xiaobaia222/fork_violentFan/fan_code/fan.md

# 暴力风扇 v2.0 重写项目

基于 STC8H 系列 MCU 的 2S 无刷暴力风扇控制器，参考 `ref_files/Violent-fan-v2.0` 开源代码进行模块化重写。

## 硬件概要

- MCU: STC8H 系列，主频 35MHz
- 电机: 2S 无刷直流电机，3 路 PWM + 互补输出 (P1.0~P1.5)
- LED: RGB 三色共阳 (R=P1.7, G=P5.4, B=P1.6)
- 按键: 单键 P3.7，支持短按/长按/双击
- 电池: 2S 锂电，ADC 通道 10 检测电压，分压比 470/(330+470)
- 充电检测: VBUS_SENSE = P3.0
- 电源开关: POWER_SWITCH = P3.1

## 模块划分

| 模块 | 文件 | 职责 |
|---|---|---|
| 主程序 | main.c/h | 时钟初始化、系统状态机、全局变量、中断入口 |
| 通用工具 | common.c/h | delay_ms、delay_us |
| LED | led.c/h | RGB LED 初始化与开关控制 |
| 按键 | key.c/h | 按键扫描(状态机)、按键事件处理 |
| 电机 | motor.c/h | PWM 初始化、六步换相、开环启动、停机 |
| ADC/电池 | adc_bat.c/h | ADC 通道10 电池电压采样、16 点去极值平均、低压保护 |
| 蜂鸣器 | (待建) | 自检蜂鸣、低压蜂鸣 |

## 开发进度

### 已完成

- [x] 项目结构搭建，模块化拆分
- [x] 时钟初始化 (35MHz)
- [x] 延时函数 (delay_ms, delay_us, delay_500ns)
- [x] LED 驱动 (RGB 推挽输出, 单色/全部开关)
- [x] 按键模块 (标准6状态消抖状态机, 短按/长按/双击)
- [x] P3.7 内部上拉使能 (P3PU)
- [x] Timer2 10ms 中断时基 + tick_10ms 节拍
- [x] LED 指示档位 (仅状态变化时更新)
- [x] 电机驱动 (motor.c)
  - [x] GPIO 初始化 (P1.0~P1.5 推挽, P3.2~P3.6 高阻, POWER_SWITCH)
  - [x] PWMA 3 通道初始化 (34kHz, 死区24T, 8位分辨率)
  - [x] ADC 初始化 (为比较器提供正输入)
  - [x] 比较器初始化 (P3.6 反相输入, 60T 滤波)
  - [x] Timer0 换相/消磁定时 + ISR
  - [x] Timer1 换相间隔测量 + ISR
  - [x] 比较器 ISR (反电动势过零检测)
  - [x] 六步换相 motor_step
  - [x] 开环启动 motor_start (渐进加速)
  - [x] 闭环切入 motor_enter_run
  - [x] 停机 motor_stop
  - [x] PWM 设置 motor_set_pwm
- [x] AM32 风格电机驱动改进
  - [x] CMP_Isr 时间窗口过滤 (< phase_time/2 丢弃)
  - [x] CMP_Isr 连续采样验证 (filter_level 次确认)
  - [x] 自适应 filter_level (10ms tick 中按转速动态调整: 8/4/2)
  - [x] IIR 滤波替代 8 点平均 (75/25 权重)
  - [x] 可配置换相提前角 (ADVANCE_LEVEL 0~3, 默认 15°)
  - [x] 消磁延时独立为 phase_time/4
  - [x] 过零计数器 zero_crosses
  - [x] 失同步检测 (CMP_Isr 中 50% 突变 → desync_flag)
  - [x] timer1_read_cnt 非破坏性读取
- [x] 主循环集成
  - [x] 10ms 节拍驱动
  - [x] PWM 一阶低通平滑
  - [x] 占空比变化率钳位 (PWM_RAMP_SLOW=3, PWM_RAMP_FAST=10)
  - [x] 失同步恢复 (油门减半 + 重置 zero_crosses)
  - [x] 堵转检测与超时停机
  - [x] 运行/闲置超时自动关机

- [x] ADC 电池电压检测 (adc_bat.c/h)
  - [x] 16 点环形缓冲去极值平均
  - [x] 低压保护阈值 6.4V (BAT_ADC_LOW=770)
  - [x] 低压自动恢复 (电压回升自动清除 STA_BATLOW)
  - [x] 低压停机蓝灯闪烁 4 次提示后休眠
- [x] 系统状态机 (main.c)
  - [x] STA_SLEEP: IDL 低功耗模式, Timer2 中断唤醒
  - [x] STA_WAKING: 长按唤醒, 判断 VBUS 决定运行/充电
  - [x] STA_CHARGING: 充电线接入检测 (轮询 VBUS_SENSE P3.0)
  - [x] 运行中插充电线立即停机进入充电休眠
  - [x] 上电默认休眠, 长按唤醒
  - [x] P3.0 高阻输入配置

### 待开发

- [ ] 蜂鸣器模块
  - [ ] 自检蜂鸣 (self_check_beebee)
  - [ ] 低压蜂鸣 (bat_low_beebee) — 当前为桩函数

## 参考代码对照

参考代码为单文件 `violent v2.0.c` (~575 行)，主要参数：

- 油门档位: 4 档 {0, 30, 80, 150}
- 蜂鸣音量: 40
- 启动油门: 40
- 堵转超时: 500ms
- 运行超时: 5min
- 闲置超时: 30s
- 低压阈值: 6.4V
