xiaobaia222/fork_violentFan/fork_Fan/设计指导.md

# 验证
电路主要参考violent_fan电路驱动，和其代码驱动先验证原电路板是否正常工作

# 改进电路 

  - [ ] 添加换启动电路参考axdr 开源驱动板，后续验证电源波形

 - [ ] 添加防反接电路 参考axdr， 利用mos管和两个电阻还有稳压管组成

 - [ ] 电池电容增加一些，加到220uf 10个22uf陶瓷电容

 - [ ] 单片机电源改为dcdc
