xiaobaia222/fork_violentFan/ref_files/Violent-fan-v2.0/HARDWARE/violent fan-v2.0-Bom.xlsx

Comment | Description | Designator | Footprint | Quantity | 参考购买链接
电容
10nF | 贴片陶瓷电容 | C9, C10, C11, C17 | C-0603-M | 4 | https://youxin-electronic.taobao.com/category-1145410923.htm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
100nF | 贴片陶瓷电容 | C3, C4, C16 | C-0603-M | 3
1uF | 贴片陶瓷电容 | C1, C6 | C-0603-M | 2
10uF | 贴片陶瓷电容 | C12, C13, C14 | C-0603-M | 3
10uF/16v | 贴片陶瓷电容 | C7, C15 | C-1206-M | 2 | https://item.taobao.com/item.htm?spm=a1z10.5-c-s.w4002-21223910190.22.aafd4da9AAzP4G&id=537890885062
22uF/16v | 贴片陶瓷电容 | C8 | C-1206-M | 1 | https://item.taobao.com/item.htm?spm=a1z10.3-c-s.w4002-21223910208.27.65956a4bOVW7yL&id=653433995995
100uF/16v | 贴片钽电容，耐压16V | C2 | C-6032-N | 1 | https://item.taobao.com/item.htm?spm=a1z09.2.0.0.360a2e8daiR1EQ&id=537026568564&_u=8b2i1bf7766 | 1.97
220uF/6.3v | 贴片钽电容，耐压6.3V | C5 | C-6032-N | 1 | https://item.taobao.com/item.htm?spm=a1z09.2.0.0.360a2e8daiR1EQ&id=536877747914&_u=8b2i1bfedb9 | 1.23
电阻
5R1 | 贴片电阻 | R15, R16, R17, R20, R21, R22 | R-0603-M | 6 | https://youxin-electronic.taobao.com/category-1171156354.htm?search=y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
22R | 贴片电阻 | R6 | R-0603-M | 1
1k | 贴片电阻 | R1, R32, R33, R35 | R-0603-M | 4
2k | 贴片电阻 | R9, R28, R29, R30 | R-0603-M | 3
4.7k | 贴片电阻 | R5 | R-0603-M | 1
5.1k | 贴片电阻 | R2, R3 | R-0603-M | 2
10k | 贴片电阻 | R4, R7, R8, R10, R11, R12, R13, R14, R18, R19, R23, R24, R25, R26, R27 | R-0603-M | 15
470k,%1 | 贴片电阻，精度1% | R34 | R-0603-M | 1 | https://item.taobao.com/item.htm?spm=a1z0d.6639537/tb.1997196601.417.2b537484oaNrWL&id=525878598378
330k,%1 | 贴片电阻，精度%1 | R31 | R-0603-M | 1 | https://item.taobao.com/item.htm?spm=a1z0d.6639537/tb.1997196601.425.2b537484oaNrWL&id=525884117853
二极管
LED-Red | 贴片红色发光二极管 | D1 | LED-0603 | 1 | https://item.taobao.com/item.htm?spm=a1z10.5-c-s.w4002-21223910190.14.121d15c27rmve0&id=522554271548
LED-RGB | 贴片三色LED | LED1 | LED 3528-4Pin | 1 | https://item.taobao.com/item.htm?spm=a1z10.5-c-s.w4002-21223910190.19.7c4115c2oQqiQW&id=544589431307
DSK34 | 贴片肖特基二极管，3A/40V | D2 | SOD-123 | 1 | https://item.taobao.com/item.htm?spm=a1z09.2.0.0.360a2e8daiR1EQ&id=545427044723&_u=8b2i1bf12fe
1N5819 | 贴片肖特基二极管 | D3, D4, D5, D6, D7, D8, D9, D10, D11 | SOD-323 | 9 | https://item.taobao.com/item.htm?spm=a1z09.2.0.0.360a2e8daiR1EQ&id=522574162326&_u=8b2i1bf39b5
三极管
S8050 | NPN型三极管 | Q2 | SOT-23 | 1 | https://item.taobao.com/item.htm?spm=a1z10.3-c-s.w4002-21223910208.11.7d136a4blLuj8S&id=522577964105
场效应管
AO3401 | P沟道场效应管 | Q1 | SOT-23 | 1 | https://item.taobao.com/item.htm?spm=a1z10.3-c-s.w4002-21223910208.9.edcb6a4bhz39m5&id=522554663865
AO3400 | N沟道场效应管 | Q3 | SOT-23 | 1 | https://item.taobao.com/item.htm?spm=a1z10.3-c-s.w4002-21223910208.9.19a96a4bDO75NZ&id=522574089119
NCE3035G | N沟道场效应管 | Q4, Q5, Q6, Q7, Q8, Q9 | DFN5x6_8L_EP1_P | 6 | https://item.taobao.com/item.htm?spm=a1z09.2.0.0.360a2e8daiR1EQ&id=674377712129&_u=9b2i1bf9a08 | 5.4
电感
SWPA5040S2R2MT | 贴片功率电感，2.2uH | L1 | CD54 | 1 | https://item.taobao.com/item.htm?spm=a1z09.2.0.0.360a2e8daiR1EQ&id=588708208400&_u=8b2i1bfc21c
集成芯片
CS5086E | 5VUSB输入，最大1.5A充电电流，带NTC及电量均衡功能，双节锂电池升压充电管理电路 | U1 | ESOP10L | 1 | https://item.taobao.com/item.htm?spm=a1z09.2.0.0.360a2e8daiR1EQ&id=673629016970&_u=9b2i1bf9d44 | 2.6
HT7150-1 | 低压差线性稳压器，5.0v，低静态电流 | U2 | SOT-89 | 1 | https://item.taobao.com/item.htm?spm=a1z09.2.0.0.35d32e8dRJrr89&id=652800148041&_u=pb2i1bf031e | 0.31
FD6288Q | 三相250V栅极驱动器 | U3 | QFN24 4x4 | 1 | https://item.taobao.com/item.htm?spm=a1z09.2.0.0.360a2e8daiR1EQ&id=613309462834&_u=9b2i1bf50a8 | 2.05
STC8H1K08 | 增强型51单片机 | U4 | TSSOP20_L | 1 | https://item.taobao.com/item.htm?spm=a1z10.3-c-s.w4002-21223910208.9.7b0c6a4bZpuTNI&id=638457107145 | 1.9
其他
10A/125V | 贴片保险丝 | F1 | FU 1808 | 1 | https://item.taobao.com/item.htm?spm=a1z09.2.0.0.360a2e8daiR1EQ&id=560195140249&_u=8b2i1bf47e2
Button | 贴片轻触开关，6*6*10 | SW1 | TSW SMD-6*6*10 | 1 | https://item.taobao.com/item.htm?spm=a1z10.3-c-s.w4002-21223910208.36.84b36a4bzG9Zgw&id=556973844714
USB-C | USB-C型母接口，6Pin | USB1 | USB-C-SMD_10P | 1 | https://item.taobao.com/item.htm?spm=a1z09.2.0.0.360a2e8daiR1EQ&id=573089663803&_u=8b2i1bf3aa2
HDR-1X4 | 2.54间距插针，4P | JP1 | HDR2.54-LI-4P-SMD | 1
BATTERY_DUAL | 贴片18650电池座，镀金，双排 | B1 | 18650电池座2P-贴片式 | 1 | https://item.taobao.com/item.htm?spm=a1z09.2.0.0.360a2e8daiR1EQ&id=589677534830&_u=8b2i1bfd1b0 | 2.69
无刷电机 | 1804无刷电机，2700kv，正螺纹 | M1 |  | 1 | https://item.taobao.com/item.htm?spm=a1z09.2.0.0.71df2e8dctWBSB&id=654440708357&_u=ab2i1bf266e | 14
螺丝 | 304十字盘头螺钉，M2*4，用于固定PCB |  |  | 2 | https://detail.tmall.com/item.htm?id=39158180791&spm=a1z09.2.0.0.6e672e8d4W5PQt&_u=mb2i1bfdf1f
螺丝 | 305十字盘头螺钉，M2*5，用于固定电机 |  |  | 4
螺母 | 304六角螺母，M5，用于固定桨叶 |  |  | 1 | https://detail.tmall.com/item.htm?id=14498839719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
桨叶 | 3.5寸8叶FPV螺旋桨 |  |  | 1 | https://item.taobao.com/item.htm?spm=a1z09.2.0.0.64462e8dkVTr0w&id=642183971152&_u=pb2i1bfa4d5 | 4.25
电池 | 动力18650电池，10A放电 |  |  | 2 | https://item.taobao.com/item.htm?spm=a1z09.2.0.0.35d32e8dRJrr89&id=571620099259&_u=pb2i1bf4f0f | 14.5
