xiaobaia222/fork_violentFan/ref_files/Violent-fan-v2.0/3DMODEL/风扇整体.SLDASM

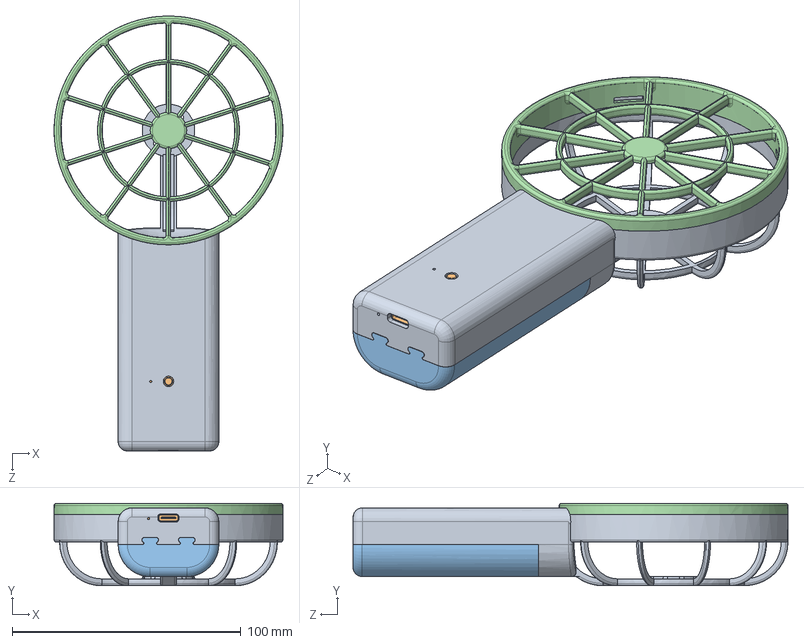
[picture p14: CAD file, 2026-01-29]
ref_files/Violent-fan-v2.0/3DMODEL/风扇整体.SLDASM
100.0 x 36.0 x 190.1 mm
风扇外壳
violent fan-v2.0
风扇后盖
风扇前盖
