xiaobaia222/fork_violentFan/ref_files/Violent-fan-v2.0/3DMODEL/风扇外壳.SLDPRT

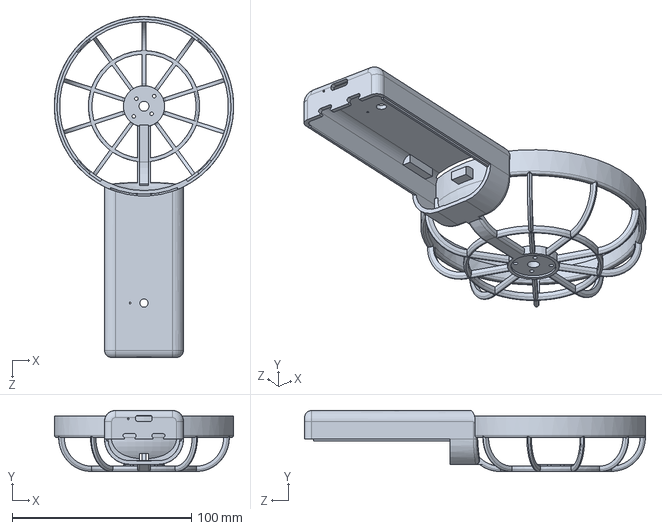
[picture p15: CAD file, 2026-01-29]
ref_files/Violent-fan-v2.0/3DMODEL/风扇外壳.SLDPRT
100.0 x 34.0 x 190.0 mm
