xiaobaia222/fork_violentFan/ref_files/Violent-fan-v2.0/3DMODEL/风扇前盖.SLDPRT

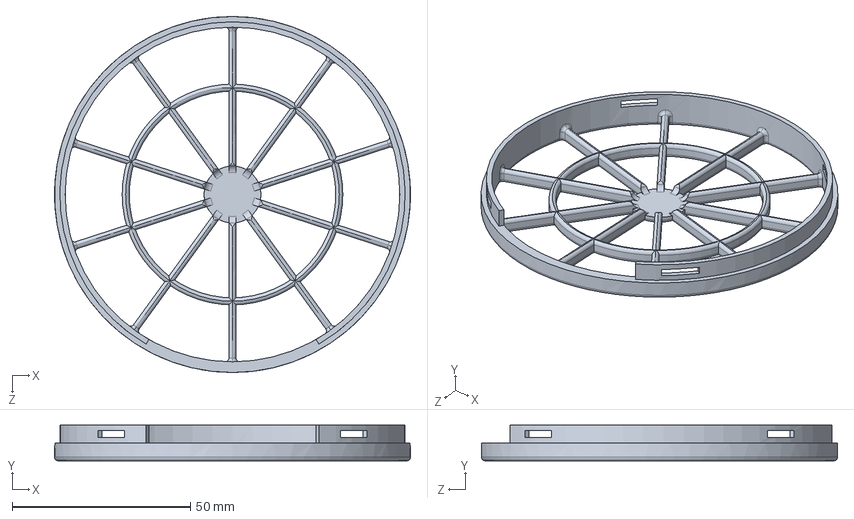
[picture p16: CAD file, 2026-01-29]
ref_files/Violent-fan-v2.0/3DMODEL/风扇前盖.SLDPRT
100.0 x 10.0 x 100.0 mm
