xiaobaia222/fork_violentFan/ref_files/Violent-fan-v2.0/3DMODEL/风扇后盖.SLDPRT

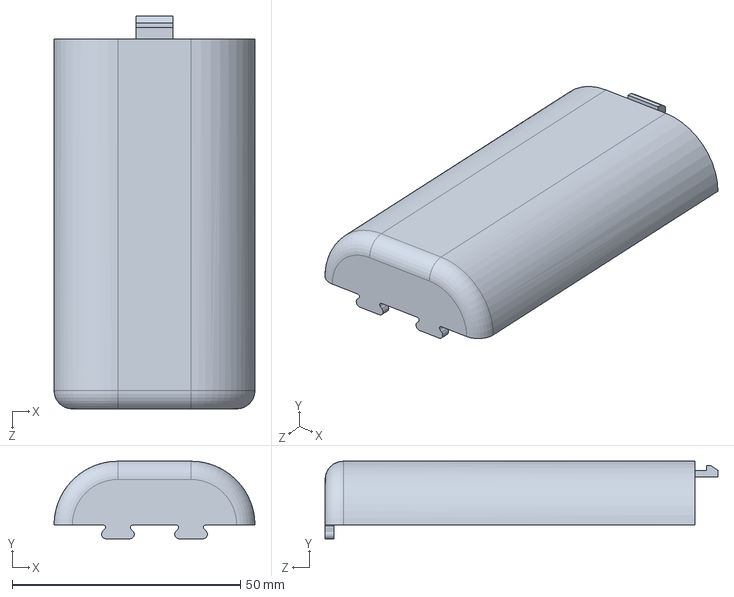
[picture p17: CAD file, 2026-01-29]
ref_files/Violent-fan-v2.0/3DMODEL/风扇后盖.SLDPRT
44.0 x 17.0 x 86.0 mm
