xiaobaia222/fork_violentFan/ref_files/Violent-fan-v2.0/3DMODEL/violent fan-v2.0.SLDPRT

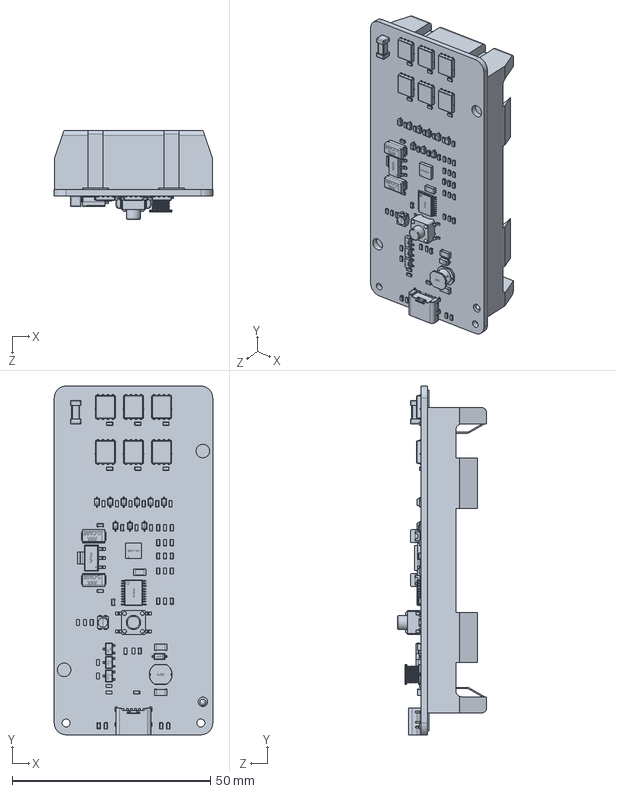
[picture p18: CAD file, 2026-01-29]
ref_files/Violent-fan-v2.0/3DMODEL/violent fan-v2.0.SLDPRT
40.0 x 88.0 x 22.5 mm
