xiaobaia222/fork_violentFan/(list of files, cad)

Other CAD files:
ref_files/Violent-fan-v2.0/3DMODEL/风扇前盖.STL
ref_files/Violent-fan-v2.0/3DMODEL/风扇后盖.STL
ref_files/Violent-fan-v2.0/3DMODEL/风扇外壳.STL
