xiaobaia222/fork_violentFan/fan_code/build_log.txt

Build target 'fan_fork'
compiling main.c...
linking...
*** WARNING L16: UNCALLED SEGMENT, IGNORED FOR OVERLAY PROCESS
    SEGMENT: ?PR?RED_ONLY?LED

*** WARNING L16: UNCALLED SEGMENT, IGNORED FOR OVERLAY PROCESS
    SEGMENT: ?PR?GREEN_ONLY?LED

*** WARNING L16: UNCALLED SEGMENT, IGNORED FOR OVERLAY PROCESS
    SEGMENT: ?PR?BLUE_ONLY?LED

*** WARNING L16: UNCALLED SEGMENT, IGNORED FOR OVERLAY PROCESS
    SEGMENT: ?PR?LED_ALL_ON?LED

*** WARNING L16: UNCALLED SEGMENT, IGNORED FOR OVERLAY PROCESS
    SEGMENT: ?PR?BAT_GET_ADC?ADC_BAT

Program Size: data=72.6 xdata=0 code=2862
creating hex file from ".\Objects\fan_fork"...
".\Objects\fan_fork" - 0 Error(s), 5 Warning(s).
Build Time Elapsed:  00:00:01
