xiaobaia222/fork_violentFan/(list of files, drawings)

Other design files:
ref_files/Violent-fan-v2.0/HARDWARE/violent fan-v2.0.PcbDoc
