xiaobaia222/fork_violentFan/fork_Fan/fork_Fan.kicad_pcb

## KiCad design fork_Fan/fork_Fan.kicad_pcb (2026-02-11)

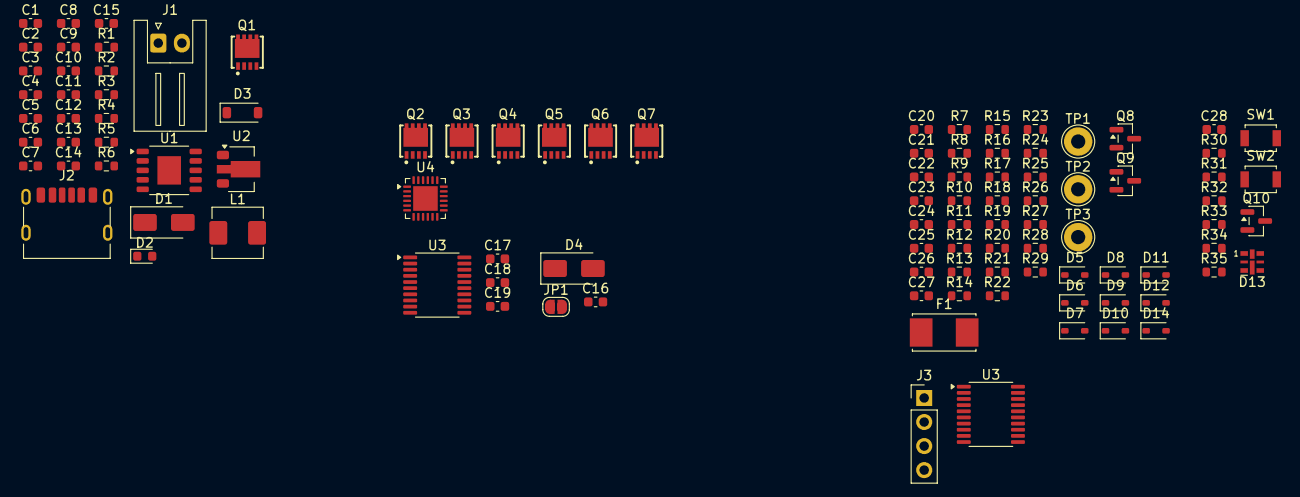
[picture p19: board fork_Fan.kicad_pcb from above]

Board: 2 copper layers, 103 parts (0 on the bottom side), 48 nets, no tracks yet.

Parts:
C1, C3, C5, C6, C7, C8, C10, C11, C12, C14, C26, C27: 10uF; C_0603_1608Metric
C2, C4, C9, C13, C15, C16, C19, C28: 100nF; C_0603_1608Metric
C17, C18: 22uF; C_0603_1608Metric
C20, C21, C22: 10nF; C_0603_1608Metric
C23, C24, C25: 1uF; C_0603_1608Metric
D1, D4: SS54; D_SMA
D2: LED; LED_0603_1608Metric
D3: BZT52B5V6; D_SOD-123
D5, D6, D7, D8, D9, D10, D11, D12, D14: 1N5819WS; D_SOD-323
D13: APA102-2020; LED-APA102-2020
F1: Fuse; Fuseholder_Littelfuse_Nano2_157x
J1: Conn_01x02; JST_XH_S2B-XH-A_1x02_P2.50mm_Horizontal
J2: USB_C_Receptacle_PowerOnly_6P; USB_C_Receptacle_HRO_TYPE-C-31-M-17
J3: Conn_01x04; PinHeader_1x04_P2.54mm_Vertical
JP1: SolderJumper_2_Open; SolderJumper-2_P1.3mm_Open_RoundedPad1.0x1.5mm
L1: 2.2uH; L_APV_APH0530
Q1, Q2, Q3, Q4, Q5, Q6, Q7: Q_NMOS; PDFN-8_L3.3-W3.3-P0.65-BL-DSG
Q8: AO3401A; SOT-23
Q9, Q10: SS8050; SOT-23
R1, R2, R4, R5: 5.1K; R_0603_1608Metric
R3: 7.5K; R_0603_1608Metric
R6, R33: 100K; R_0603_1608Metric
R7, R8, R9, R10, R11, R12: 5.1R; R_0603_1608Metric
R13, R14, R15, R16, R17, R18, R19, R20, R21, R22, R23, R24, R28, R31: 10K; R_0603_1608Metric
R25, R26, R27, R29, R30, R34, R35: 2K; R_0603_1608Metric
R32: 200K; R_0603_1608Metric
SW1, SW2: SW_Push; SW_SPST_B3U-1000P
TP1, TP2, TP3: TestPoint; TestPoint_THTPad_D3.0mm_Drill1.5mm
U1: CS5086E; SSOP-10-1EP_3.9x4.9mm_P1mm_EP2.5x3.0mm
U2: HT7150-1; SOT-89-3
U3: STC8G1K08-38I-TSSOP20; TSSOP-20_4.4x6.5mm_P0.65mm
U3#2: STC8H1K08-38I-TSSOP20; TSSOP-20_4.4x6.5mm_P0.65mm
U4: FD6288Q; QFN-24-1EP_4x4mm_P0.5mm_EP2.6x2.6mm

Connections:
+5V: C14.1, C15.1, C17.1, C18.1, C19.1, D13.1 (VDD), J3.1, U2.3 (VOUT), U3.8 (VCC), U3#2.8 (VCC), U3#2.9 (ADC_VRef+)
/IO_opera/bat_sample: C28.1, R34.1
/motor_driver/A: C23.2, Q2.D, Q3.S, R13.2, R19.1, TP1.1, U4.18 (VS1)
/motor_driver/ADC11: C20.2, R19.2, R22.1, R25.1
/motor_driver/ADC12: C21.2, R20.2, R23.1, R26.1
/motor_driver/ADC13: C22.2, R21.2, R24.1, R27.1
/motor_driver/B: C24.2, Q4.D, Q5.S, R14.2, R20.1, TP2.1, U4.15 (VS2)
/motor_driver/C: C25.2, Q6.D, Q7.S, R18.2, R21.1, TP3.1, U4.12 (VS3)
/motor_driver/COMP-: R22.2, R23.2, R24.2
/motor_driver/M_A_H1: D5.1 (K), R7.1, U4.19 (HO1)
/motor_driver/M_A_L1: D6.1 (K), R8.1, U4.11 (LO1)
/motor_driver/M_B_H2: D7.1 (K), R9.1, U4.16 (HO2)
/motor_driver/M_B_L2: D8.1 (K), R10.1, U4.10 (LO2)
/motor_driver/M_C_H3: D9.1 (K), R11.1, U4.13 (HO3)
/motor_driver/M_C_L3: D10.1 (K), R12.1, U4.9 (LO3)
/motor_driver/VB_A: C23.1, D14.1 (K), U4.20 (VB1)
/motor_driver/VB_B: C24.1, D11.1 (K), U4.17 (VB2)
/motor_driver/VB_C: C25.1, D12.1 (K), U4.14 (VB3)
/stc_mcu/RX: J3.4, U3#2.12 (TxD/ADC9/P3.1)
/stc_mcu/TX: J3.3, U3#2.11 (INT4/RxD/ADC8/P3.0)
GND: C1.2, C2.2, C3.2, C4.2, C5.2, C6.2, C7.2, C8.2, C9.2, C10.2, C11.2, C12.2, C13.2, C14.2, C15.2, C16.2, C17.2, C18.2, C19.2, C20.1, C21.1, C22.1, C26.2, C27.2, C28.2, D3.2 (A), D13.6 (GND), J2.A12 (GND), J2.B12 (GND), J2.S1 (SHIELD), J3.2, Q1.S, Q3.D, Q5.D, Q7.D, Q9.2 (E), Q10.2 (E), R1.2, R2.2, R3.2, R15.2, R16.2, R17.2, R25.2, R26.2, R27.2, R33.2, SW1.2, SW2.2, U1.4 (AGND), U1.11 (EP), U2.1 (GND), U3.10 (GND), U3#2.10 (GND), U4.6 (COM)
unnamed: D1.2 (A), L1.2, U1.5 (LX)
unnamed: C3.1, C4.1, C5.1, C6.1, D1.1 (K), U1.6 (VBS)
unnamed: D2.2 (A), R4.2
unnamed: D2.1 (K), R5.2, U1.2 (STAT)
unnamed: C16.1, D3.1 (K), JP1.2 (B)
unnamed: C12.1, C13.1, D4.1 (K), U2.2 (VIN)
unnamed: D5.2 (A), Q2.G, R7.2, R13.1
unnamed: D6.2 (A), Q3.G, R8.2, R15.1
unnamed: D7.2 (A), Q4.G, R9.2, R14.1
unnamed: D8.2 (A), Q5.G, R10.2, R16.1
unnamed: D9.2 (A), Q6.G, R11.2, R18.1
unnamed: D10.2 (A), Q7.G, R12.2, R17.1
unnamed: F1.2, Q2.S, Q4.S, Q6.S
unnamed: J2.A5 (CC1), R1.1
unnamed: J2.B5 (CC2), R2.1
unnamed: JP1.1 (A), Q1.G, R6.2
unnamed: Q8.1 (G), Q9.3 (C), R28.2
unnamed: Q9.1 (B), R29.1
unnamed: Q10.1 (B), R31.2
unnamed: R30.2, SW1.1
unnamed: R32.2, R33.1, R34.2
unnamed: R35.2, SW2.1
unnamed: R3.1, U1.10 (ICHG)
P_GND: J1.2, Q1.D
VBUS: C1.1, C2.1, C7.1, J2.A9 (VBUS), J2.B9 (VBUS), L1.1, R4.1, R31.1, U1.3 (VIN)
VDRV: C26.1, C27.1, D11.2 (A), D12.2 (A), D14.2 (A), Q8.3 (D), U4.4 (VCC)
Vbat: C8.1, C9.1, C10.1, C11.1, D4.2 (A), F1.1, J1.1, Q8.2 (S), R6.1, R28.1, R32.1, U1.7 (BAT)
