xiaobaia222/fork_violentFan/fan_code/inc/led.h

#ifndef __LED_H__
#define __LED_H__




void led_init(void);
void led_r_on(void);
void led_g_on(void);
void led_b_on(void);
void led_r_off(void);
void led_g_off(void);
void led_b_off(void);
void led_all_off(void);
void led_all_on(void);
void red_only(void);
void green_only(void);
void blue_only(void);


#endif
