xiaobaia222/fork_violentFan/(commit log)

2026-01-29 init fork file
    [fork_Fan.kicad_pcb, fork_Fan.kicad_sch, violent fan-v2.0-Bom.xlsx, violent fan-v2.0.PcbDoc, violent fan-v2.0.SLDPRT, violent v2.0.obj, 风扇前盖.SLDPRT, 风扇前盖.STL]
2026-01-29 power and chrg complete
    [IO_opera.kicad_sch, fork_Fan.kicad_pcb, fork_Fan.kicad_sch, motor_driver.kicad_sch, power_chrg.kicad_sch, stc_mcu.kicad_sch]
2026-01-29 add mcu and some motor driver need bat sample, key, programing pad, fuse, fd6288 power.
    [fork_Fan.kicad_pcb, motor_driver.kicad_sch, power_chrg.kicad_sch, stc_mcu.kicad_sch]
2026-01-31 完善原理图，还未完成
    [IO_opera.kicad_sch, motor_driver.kicad_sch, stc_mcu.kicad_sch]
2026-02-11 fix code
    [fork_Fan.kicad_pcb, power_chrg.kicad_sch]
2026-03-04 使用cursor完成按键的功能
2026-03-04 电机可以启动，但是第一档有点不顺滑，会突变一下
2026-03-04 AI学习am32代码改进原来的代码
2026-04-04 暂时提交
2026-04-04 重构主循环状态机，修复开机无反应问题
    - 将 STA_* 位标志替换为互斥枚举 state_t（SLEEP/CHARGING/RUNNING），
    消除非法状态组合，状态转移逻辑更清晰
    - 消除 STA_WAKING 中间状态，key_handle() 直接判断 VBUS_SENSE 完成转移，
    修复原设计 key_handle 与 tick 时序不同步的竞态问题
    - 修复 POWER_SWITCH 在 init() 中提前置 0 导致上电 LED 双闪不可见
    - 修复 P3.0 (VBUS_SENSE) 悬空误判充电线接入，导致长按后立即返回休眠
    - 充电状态新增蓝灯慢闪（50/100 tick 非阻塞计数）
    [key.c, main.c, main.h]
2026-04-04 低功耗优化：掉电模式 + WKTR 喂狗
    休眠/充电时进入 PDN 掉电模式（PCON|=0x02）而非空闲模式：
    - sleep_enter()：关闭 Timer2/Timer0/Timer1、ADC、比较器，
    启动掉电唤醒定时器（WKTCL/WKTCH，约 100ms/次，32KHz）
    - sleep_exit() ：关闭 WKTR，重启 Timer2，恢复 ADC 和比较器
    - 掉电期间 WDT 暂停；WKTR 每 100ms 唤醒后立即喂狗（WDT_PS=7）
    - 睡眠中按键通过 100ms 轮询检测（10 次 = 1s 长按），
    不依赖 key.c 状态机，唤醒后调用 key_init() 重置按键状态
    - 充电线插拔在低功耗循环内实时检测，无需唤醒到运行模式
2026-04-04 修复开机后立即关机：长按松手后再切换到运行模式
