xiaobaia222/fork_violentFan/(notices)

Notices in the files:
ref_files/Violent-fan-v2.0/CODE/violent v2.0-20230610/tools/stcflash.py:
This program is free software: you can redistribute it and/or modify
it under the terms of the GNU General Public License as published by
the Free Software Foundation, either version 3 of the License, or
(at your option) any later version.
